Alex-Zor/PentaDiv3Plus/A1/firmware0.3/Atmega8/Fuses.png

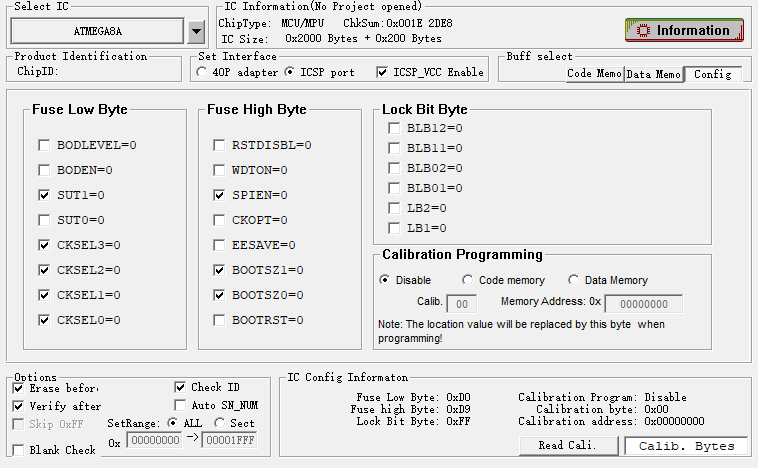
A1/firmware0.3/Atmega8/Fuses.png
