Alex-Zor/PentaDiv3Plus/A1/firmware0.3/CPLD/CPLD Programming.png

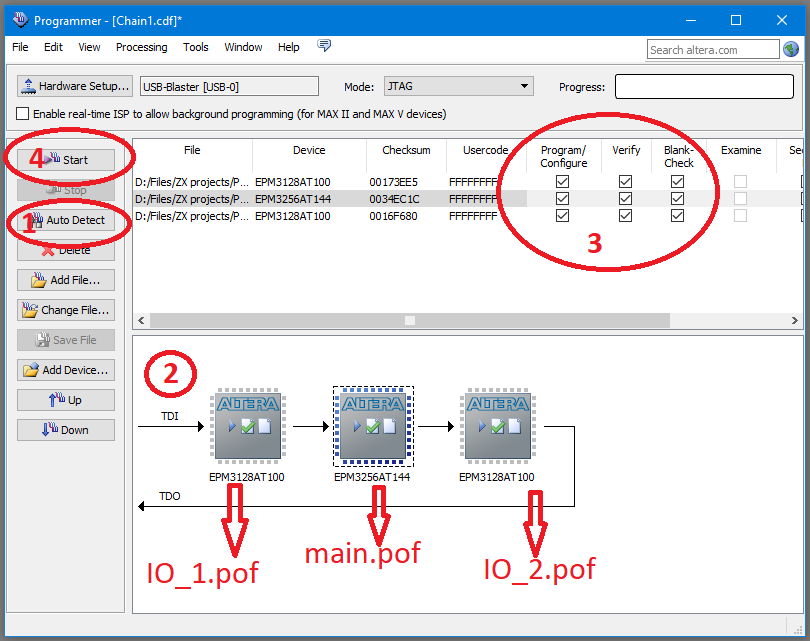
A1/firmware0.3/CPLD/CPLD Programming.png
