Alex-Zor/PentaDiv3Plus/A1/Schematic/PentaDiv3Plus_A1.pdf

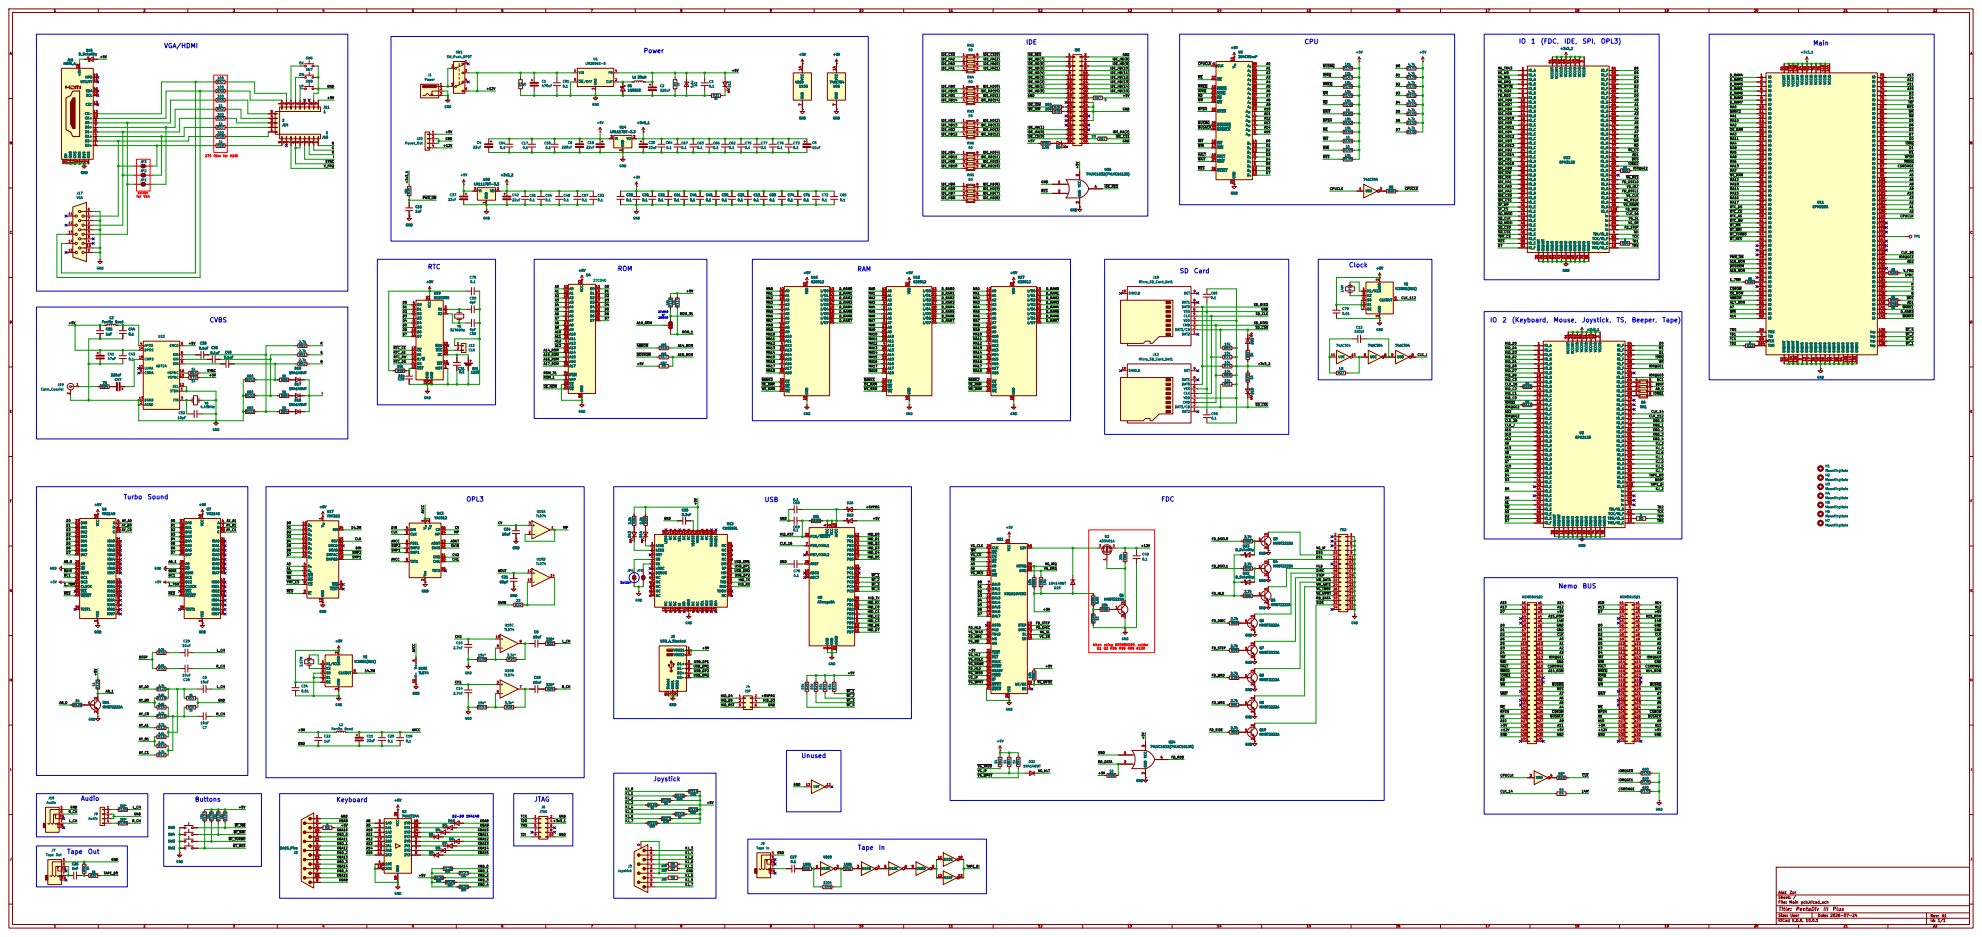
[picture p8: page 1]

IO 1 (FDC, IDE, SPI, OPL3)

8 D0- 9 CK+ 10 CKS 11 CK- 12 CEC 13 UTILITY 14

INT 16 NMI 17 HALT 18 MREQ

270 Ohm for HDMI solder

IO 2 (Keyboard, Mouse, Joystick, TS, Beeper, Tape)

SMPBD 19 SMPAC 20 DOAB 21 DOCD 22 ΦSY 23 ΦM 24 U17
YMF262

Alez Zor
Sheet: /
File: Main pcb.kicad_sch
Title: PentaDiv III Plus

Size: User | Rev: A1
KiCad E.D.A. 10.0.1 | Id: 1/1
